Bidhan0124/nrf52840-macropad/BOM.csv

ID | Name | Designator | Footprint | Quantity | Manufacturer Part | Manufacturer | Supplier | Supplier Part | Price
1 | 1.3_OLED_4P_MODULE | OLED1 | 1.3OLED_4P | 1 | 0.96OLED_4P_MODULE_JX | null | LCSC | C9900004566
2 | Header-Female-2.54_1x13 | P1,P2 | HDR-TH_13P-P2.54-V-F | 2 | 2.54-1*13P母 | BOOMELE(博穆精密) | LCSC | C52709 | 0.142
3 | ROTARY_ENCODER_WITHLABELS | RE1,RE2 | ROTARYENCODER | 2
4 | CHERRY_CHERRY_MX | S1,S2,S3,S4,S5,S6 | CHERRY MX 1U | 6
