Bidhan0124/nrf52840-macropad/hardware/pdf/MACRO_PAD_SCH_V1.pdf

## GND GND

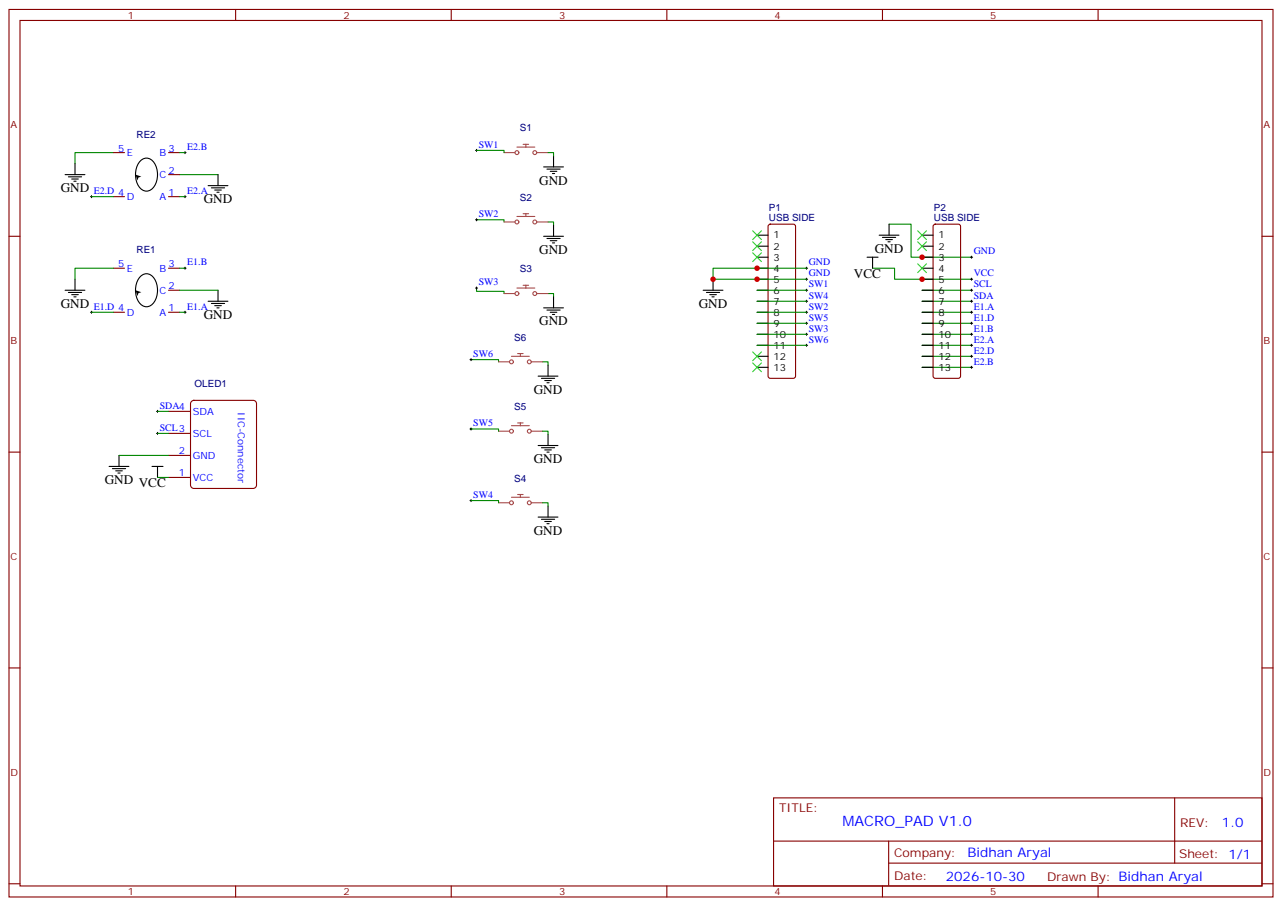
[picture p2: page 1]

Drawn By: Bidhan Aryal
