Bidhan0124/nrf52840-macropad/hardware/pdf/MACRO_PAD_PCB_V1.pdf

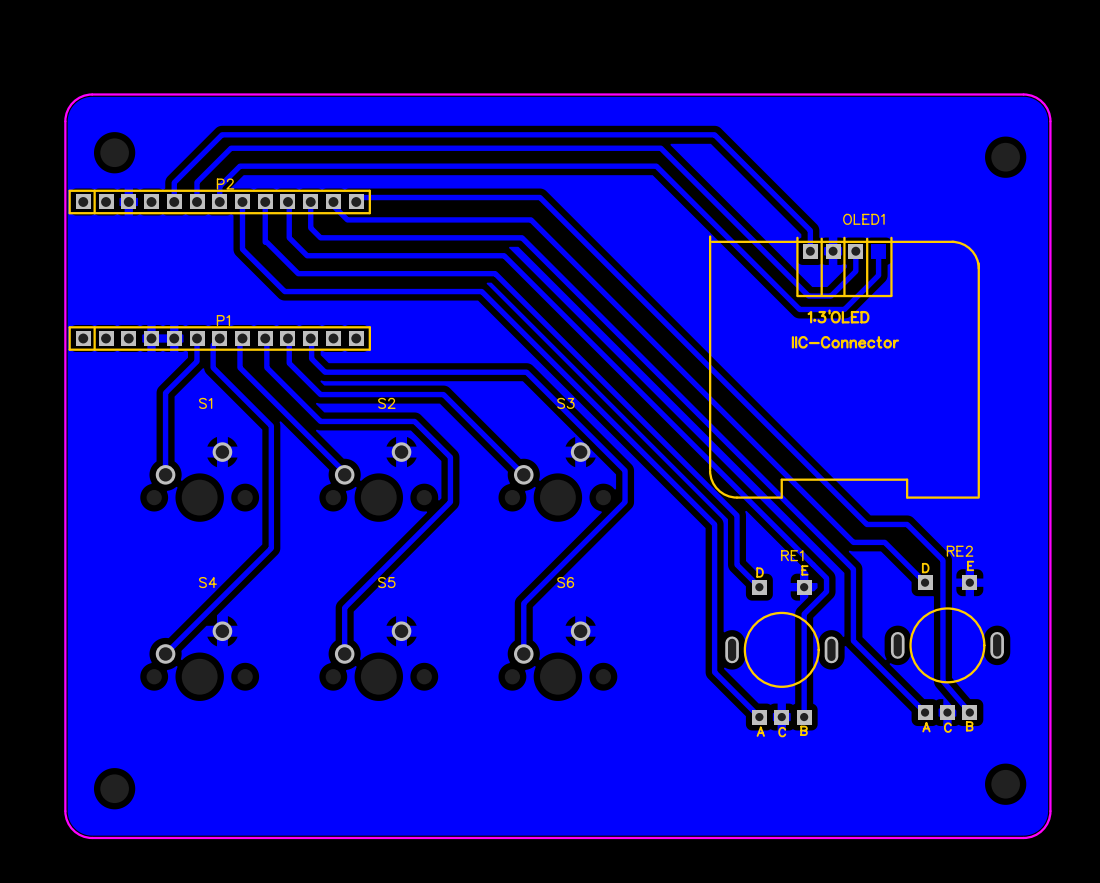
[picture p3: page 1]
