Bidhan0124/nrf52840-macropad/(list of files, drawings)

Other design files:
hardware/easyeda/MACRO_PAD_V1.json
