Bidhan0124/nrf52840-macropad/(commit log)

2026-10-31 added files
    macro pad v1
    [BOM.csv]
2026-10-31 Revise README for nRF52840 Macro Pad project
    Updated project description, features, parts list, pin assignments, repository contents, building instructions, firmware plans, known limits, and license information.
2026-10-31 Add PCB v0.1 design files
    [BOM.csv, MACRO_PAD_V1.json]
2026-10-31 Add firmware, SuperMini pin mappings, and GitHub Actions workflow
